apfelaudio/tiliqua/(notices)

Notices in the files:
hardware/tiliqua-motherboard/tiliqua-motherboard.kicad_pcb:
CERN-OHL-S V2
